Ulmstedt/Synth/docs/Bilder/20150524_132819.jpg

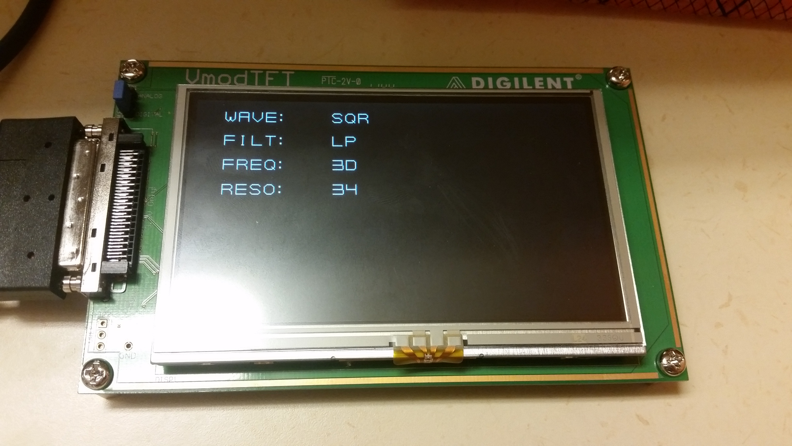
docs/Bilder/20150524_132819.jpg
