Ulmstedt/Synth/docs/Bilder/20150524_132806.jpg

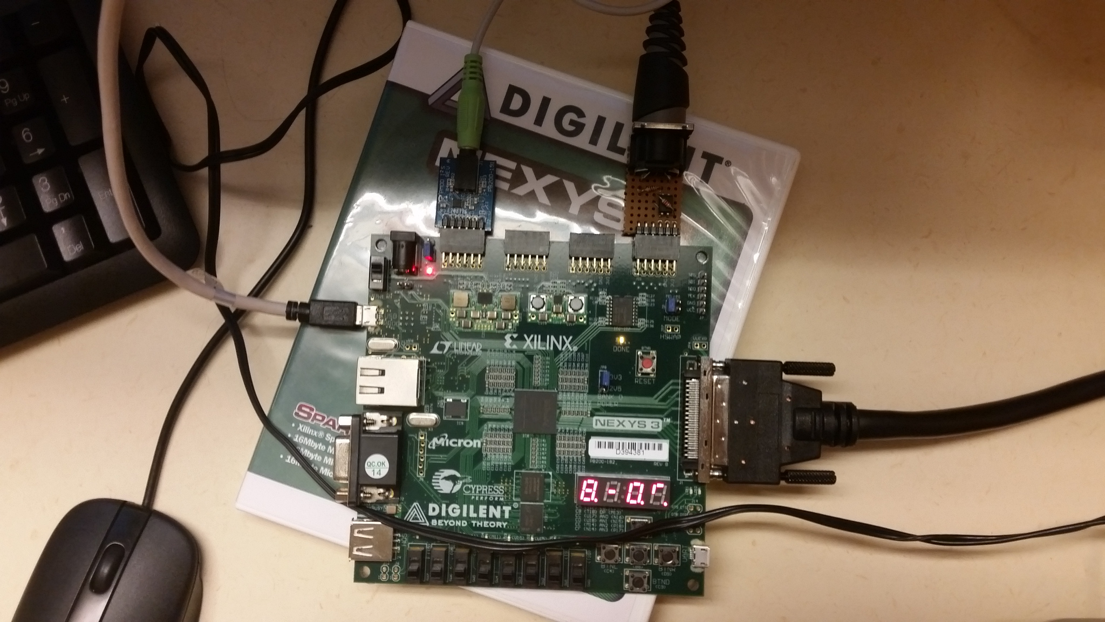
docs/Bilder/20150524_132806.jpg
