Ulmstedt/Synth/docs/psuedo/description.txt

Version 1:
OSCs (only 1, 3 voices)
   => Mixer 
      => Filter (up to 2)
         => Mixer
            => Output
