Ulmstedt/Synth/docs/7-seg display fixed.png

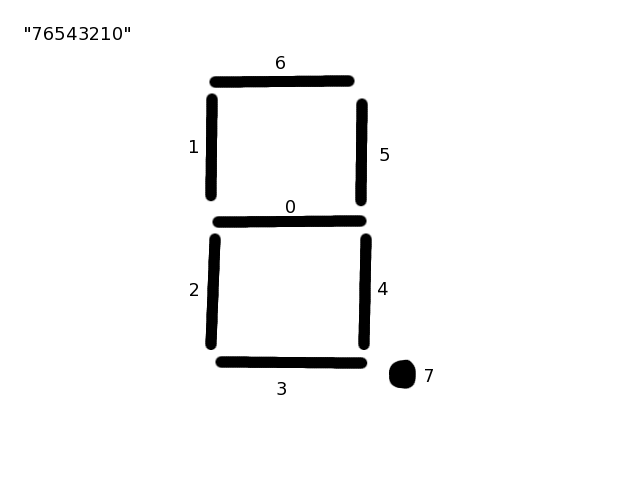
docs/7-seg display fixed.png
