Ulmstedt/Synth/docs/Bilder/20150524_132828.jpg

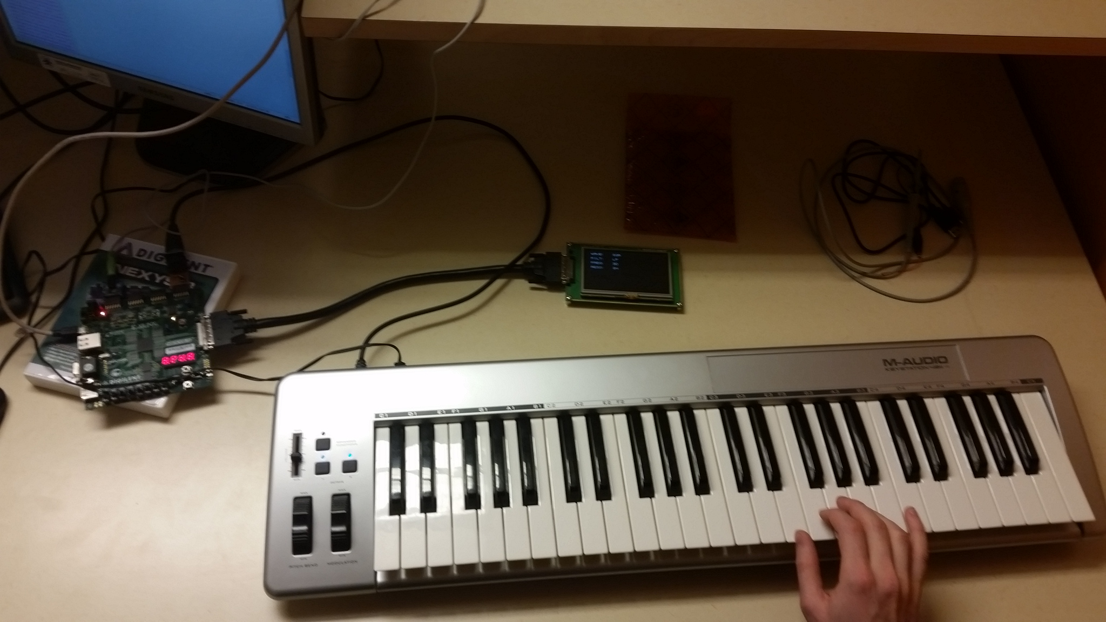
docs/Bilder/20150524_132828.jpg
