Ulmstedt/Synth/docs/Bilder/MinimoogVoyager.jpg

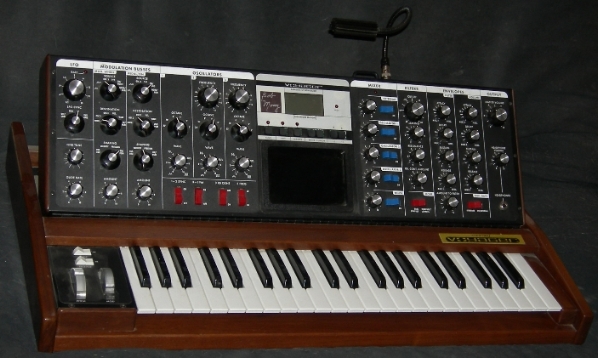
docs/Bilder/MinimoogVoyager.jpg
