Ulmstedt/Synth/docs/JUMPSTALL.png

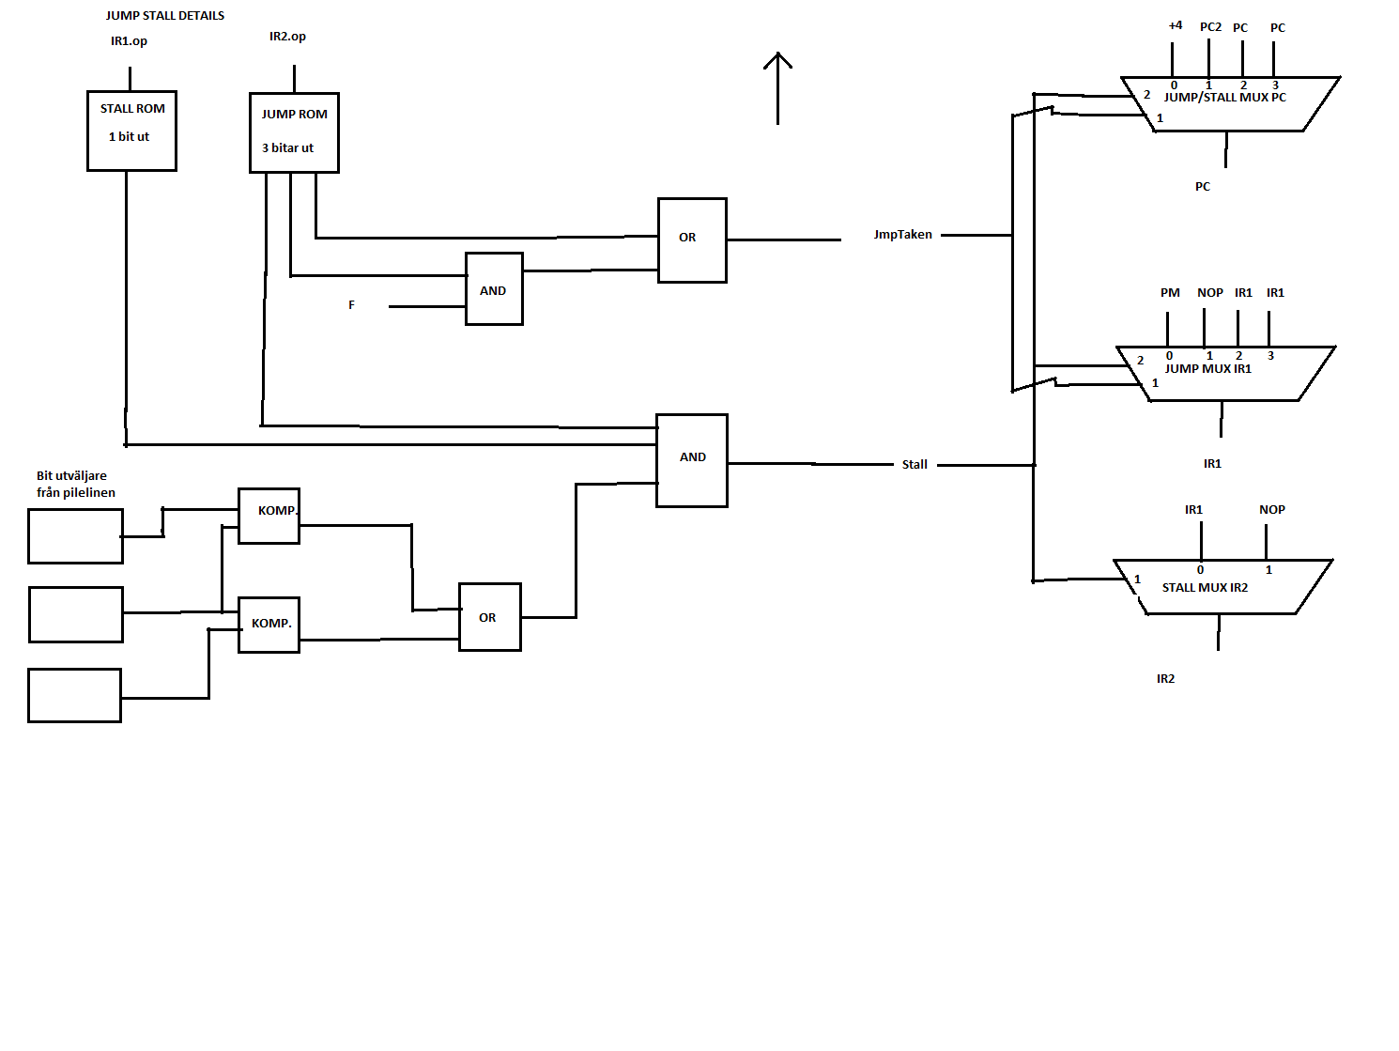
docs/JUMPSTALL.png
