Ulmstedt/Synth/docs/skiss2.png

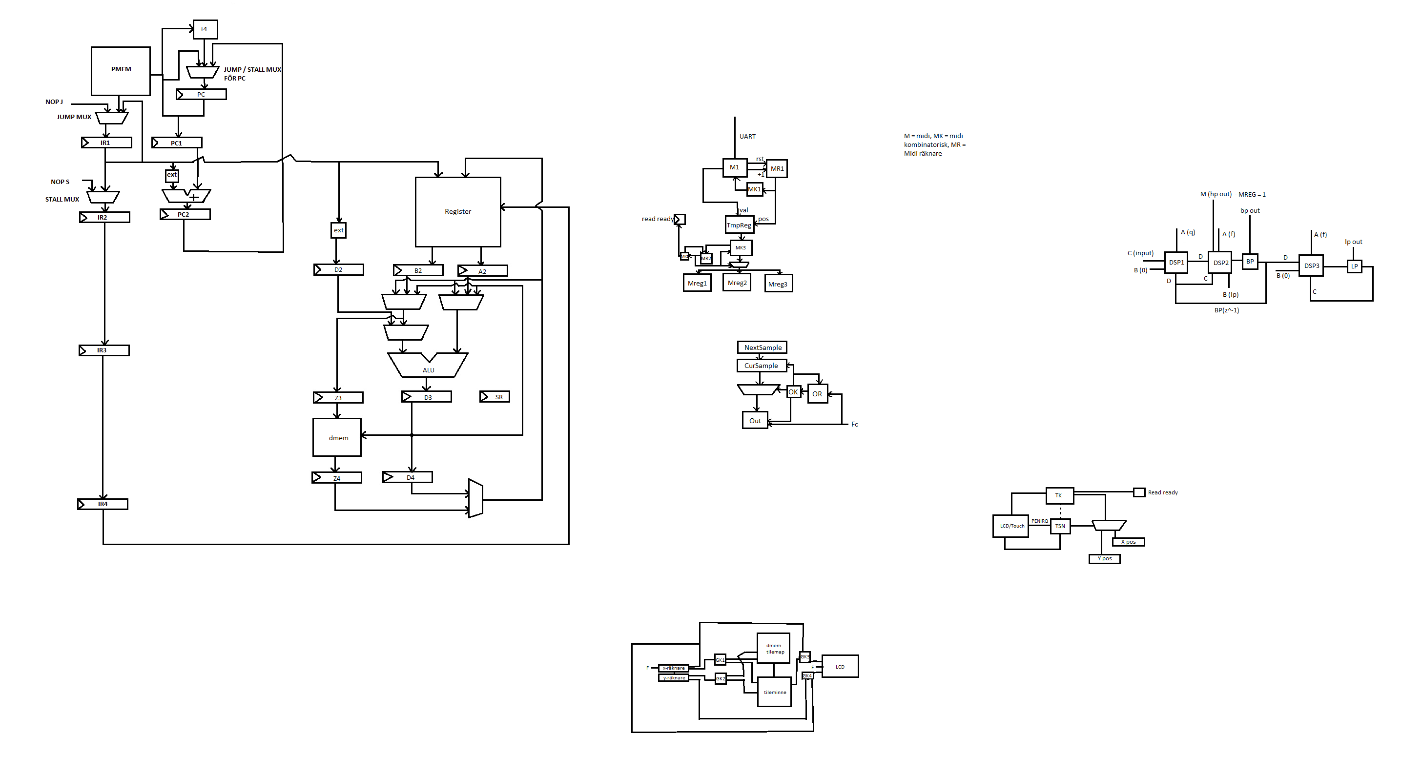
docs/skiss2.png
