Ulmstedt/Synth/compiler/test.txt

&hej
NOP
&hej2
BRA #hej3   ; Kommentar
NOP
NOP
&hej3
