Ulmstedt/Synth/docs/checklista_testing_of_cpu.xls

Skriv typ av test i högra kolumnerna
 | Typ av test:
Instruktion | 1 line | flera lines samma instr.
NOP | ok
TRAP
STORE.c | ok | ok, kan stora på olika adresser osv var tvungen att integrera D3 med ALU ty ALUn är kockad
STORE.r
STORE.wo
STORE.wofr
LOAD.a | ok | verkar ok, var tvungen att integrera Z4 med minnet ty minnet är klockat
LOAD.c
LOAD.wo
LOAD.wro
MOVE
BRANCH(till adress)
BRANCH(offset i register)
BRANCH(offset från där man står)
BCC
BCC(offset i reg)
BCC(offset från där man står)
BNCC
BNCC(offset i reg)
BNCC(offset från där man står)
ALUINST.r
ALUINST.c
