Ulmstedt/Synth/cpu/pmem_content.vhd

library IEEE;
use IEEE.std_logic_1164.all;
use IEEE.numeric_std.all;

use work.records.all;


package pmemContent is
   -- The content of the program memory
   constant pmemc : pmem_t := (
         ("11101100100000000000100000000000"),
         ("11101100110000001111110111101000"),
         ("11101000000000000000000000001010"),
         ("11101000100000000000000000001010"),
         ("00110001110000000000000000001000"),
         ("00110001110001000000000000001000"),
         ("11101000010000000000000000000000"),
         ("00101001010000000000000000000010"),
         ("00000000000000000000000000000000"),
         ("11011001111111110000000000000001"),
         ("00000000000000000000000000000000"),
         ("00110001000000000000000000000001"),
         ("00110011000000000000000000000000"),
         ("00000000000000000000000000000000"),
         ("10100000000000000000000000001000"),
         ("00000000000000000000000000000000"),
         ("11000001111101000000000110100101"),
         ("11000001111101010111111111111111"),
         ("10000011100000000000000000011010"),
         ("00000000000000000000000000000000"),
         ("10000010100000000000000010001011"),
         ("00000000000000000000000000000000"),
         ("10000011000000000000000010110110"),
         ("00000000000000000000000000000000"),
         ("01000000000000000000000000010010"),
         ("00000000000000000000000000000000"),
         ("00100010100000000000000000011101"),
         ("00110001100101000000000000001100"),
         ("00100000000000000000000000011101"),
         ("00110010000000000000000011111111"),
         ("00100000010000000000000000011110"),
         ("00110011000101000000000000001011"),
         ("10000000000000000000000001010001"),
         ("00000000000000000000000000000000"),
         ("00110011000101000000000000001110"),
         ("10000000000000000000000001100100"),
         ("00000000000000000000000000000000"),
         ("00110011000000000000000001010100"),
         ("10000000000000000000000010001000"),
         ("00000000000000000000000000000000"),
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

      others =>
         ("00000" & "000" & "0000" & "0000" & "0000" & "0000" & "0000" & "0000")
      );
      
end pmemContent;
