Ulmstedt/Synth/TouchLCD/InputtoLCD/tilememcontent.vhd

--Tiles are stored here

library IEEE;
use IEEE.std_logic_1164.all;
use IEEE.numeric_std.all;

use work.Constants.all;

   --1 tile = 16x16 pixlar
   --30 tiles i x-led
   --17 tiles i y-led
   --30*17= tiles totalt på skärmen
   --dmem 16 bitar brett
   -- XXXX XXXX XXXX XXXX
   --Behöver 5 bitar för att peka ut rätt tile i tilemem
   -- Varje minnesplats i dmem får hålla reda på 3 tiles
   --1 vit
   --0 svart

package tilememContent is
   type tile_mem_c is array (0 to TILE_DIM - 1) of std_logic_vector(0 to TILE_DIM - 1);
   type tile_mem_t is array (0 to TILE_MEM_HEIGHT - 1) of tile_mem_c;

   constant tileMemoryContent : tile_mem_t := (
         --0
         (("0011111111111100"),
          ("0010000000001100"),
          ("0010000000010100"),
          ("0010000000100100"),
          ("0010000001000100"),
          ("0010000010000100"),
          ("0010000100000100"),
          ("0010001000000100"),
          ("0010010000000100"),
          ("0010100000000100"),
          ("0011000000000100"),
          ("0010000000000100"),
          ("0011111111111100"),
          ("0000000000000000"),
          ("0000000000000000"),
          ("0000000000000000")),
         --1
         (("0000000010000000"),
          ("0000000110000000"),
          ("0000001010000000"),
          ("0000000010000000"),
          ("0000000010000000"),
          ("0000000010000000"),
          ("0000000010000000"),
          ("0000000010000000"),
          ("0000000010000000"),
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
          ("0000000000000000"),
          ("0001100000000000"),
          ("0001100000000000"),
          ("0000000000000000"),
          ("0000000000000000"),
          ("0000000000000000"),
          ("0000000000000000"),
          ("0000000000000000"))
      );
      
end tilememContent;
