Ulmstedt/Synth/cpu/mem_content.vhd

library IEEE;
use IEEE.std_logic_1164.all;
use IEEE.numeric_std.all;

use work.records.all;
use work.Constants.all;


package memContent is
   constant memc : mem_t := (
      -- Wavetables note multipliers (calculated in advance as: freq * wavetable_length / sample rate
      ("0000000010110000"), -- C0
      ("0000000010111010"),
      ("0000000011000101"),
      ("0000000011010001"),
      ("0000000011011101"),
      ("0000000011101010"),
      ("0000000011111000"),
      ("0000000100000111"),
      ("0000000100010111"),
      ("0000000100100111"),
      ("0000000100111001"),
      ("0000000101001011"),
      ("0000000101011111"),
      ("0000000101110100"),
      ("0000000110001010"),
      ("0000000110100010"),
      ("0000000110111010"),
      ("0000000111010101"),
      ("0000000111110000"),
      ("0000001000001110"),
      ("0000001000101101"),
      ("0000001001001111"),
      ("0000001001110010"),
      ("0000001010010111"),
      ("0000001010111110"),
      ("0000001011101000"),
      ("0000001100010100"),
      ("0000001101000011"),
      ("0000001101110101"),
      ("0000001110101010"),
      ("0000001111100001"),
      ("0000010000011100"),
      ("0000010001011011"),
      ("0000010010011101"),
      ("0000010011100100"),
      ("0000010100101110"),
      ("0000010101111100"),
      ("0000010111010000"),
      ("0000011000101000"),
      ("0000011010000111"),
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
      -- 64 step square wave
      ("1000000001000000"), 
      ("1000000001000000"), 
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
      ("1011100000100100"), 
      ("1011000000101000"), 
      ("1010100000101100"), 
      ("1010000000110000"), 
      ("1001100000110100"), 
      ("1001000000111000"), 
      ("1000100000111100"), 
      ("1000000001000000"), 
      ("1000100000111100"), 
      ("1001000000111000"), 
      ("1001100000110100"), 
      ("1010000000110000"), 
      ("1010100000101100"), 
      ("1011000000101000"), 
      ("1011100000100100"), 
      ("1100000000100000"), 
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
      -- Cordic
      --TILE_MAP_OFFSET =>
      --   ("0000" & "0001" & "0000" & "0001" ),
      --TILE_MAP_OFFSET + 4 =>
      --   ("0000" & "0001" & "0000" & "0001" ),
      others =>
         ("0000" & "0000" & "0000" & "0000" )
      );
      
end memContent;
