Ulmstedt/Synth/cpu/tilemap_content.vhd

--Actual tilemap

library IEEE;
use IEEE.std_logic_1164.all;
use IEEE.numeric_std.all;

use work.records.all;
use work.Constants.all;


package tilemapContent is
   constant tilemapc : tilemap_t := (
         ("00011110" & "00011110" ),
         ("00011110" & "00011110" ),
         ("00011110" & "00011110" ),
         ("00011110" & "00011110" ),
         ("00011110" & "00011110" ),
         ("00011110" & "00011110" ),
         ("00011110" & "00011110" ),
         ("00011110" & "00011110" ),
         ("00011110" & "00011110" ),
         ("00011110" & "00011110" ),
         ("00011110" & "00011110" ),
         ("00011110" & "00011110" ),
         ("00011110" & "00011110" ),
         ("00011110" & "00011110" ),
         ("00011110" & "00011110" ),

         ("00011110" & "00011110" ),   -- 768+15=783
         ("00011100" & "00001010" ),   -- WA
         ("00011011" & "00001110" ),   -- VE
         ("00011111" & "00011110" ),   -- :
         ("00011110" & "00011110" ),
         ("00011110" & "00011110" ),
         ("00011110" & "00011110" ),
         ("00011110" & "00011110" ),   -- Value here
         ("00011110" & "00011110" ),
         ("00011110" & "00011110" ),
         ("00011110" & "00011110" ),
         ("00011110" & "00011110" ),
         ("00011110" & "00011110" ),
         ("00011110" & "00011110" ),
         ("00011110" & "00011110" ),

         
         ("00011110" & "00011110" ),
         ("00011110" & "00011110" ),
         ("00011110" & "00011110" ),
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
         ("00011110" & "00011110" ),
         ("00011110" & "00011110" ),
         ("00011110" & "00011110" ),
         ("00011110" & "00011110" ),
         ("00011110" & "00011110" ),

      others =>
         ("00011110" & "00011110" )
      );
      
end tilemapContent;
