Ulmstedt/Synth/midiinput/midi_mux_counter.vhd

library IEEE;
use IEEE.std_logic_1164.all;
use IEEE.numeric_std.all;

use work.midi_constants.all;

-- This section makes sure that the MIDI messages are saved to the correct registers

entity MuxCounter is
   port(
      clk               : in std_logic; -- Clock
      rst               : in std_logic; -- Reset
      validMsgI         : in std_logic; -- 1 when the message in tmpReg is valid
      msgReadyDelayed   : in std_logic; -- 1 when a message is ready in tmpReg
      muxCtr            : out std_logic_vector(1 downto 0); -- MUX counter
      outReady          : out std_logic -- 1 when the message is ready to be transfered from tmpReg to mreg#
   );
end MuxCounter;

architecture Behavioral of MuxCounter is

signal count      : std_logic_vector(1 downto 0) := "00";
signal outReadyS  : std_logic := '0';

begin

   process(clk) is
   begin
      if rising_edge(clk) then
         if rst = '1' then
            count <= "00";
         else
           if validMsgI = '1' and msgReadyDelayed = '1' then
               case count is
                  when "00" =>
                           count <= "01";
                           outReadyS <= '1';
                  when "01" =>
                           count <= "10";
                           outReadyS <= '1';
                  when "10" =>
                           count <= "11";
                           outReadyS <= '1';
                  when others => null;
               end case;
            elsif validMsgI = '0' then
               count <= "00";
            end if;
           
            -- Out ready should only be 1 for 1 clk
            if outReadyS = '1' then
               outReadyS <= '0';
            end if;
            
         end if;
      end if;
   end process;

   muxCtr <= count;
   outReady <= outReadyS;


end Behavioral;
