Ulmstedt/Synth/TouchLCD/backlightpwmsignal.vhd

--transform clk signal to pwm signal to drive backlight of LCD
library IEEE;
use IEEE.std_logic_1164.all;
use IEEE.numeric_std.all;

entity backlightpwmsignal is
   port(
      rst   : in std_logic;
      clk   : in std_logic;
      F     : out std_logic --desired frequency 50 kHz
   );
end backlightpwmsignal;

architecture Behavioral of backlightpwmsignal is
   signal temp   :  std_logic;
   signal counter: integer range 0 to 999 := 0; --(100 000 000 / 50 000)/2

   
--Produces a clock frequency of 50kHz
begin
   process(clk)
   begin
   if(rising_edge(clk)) then
      if(rst = '1') then
         temp <= '0'; --0
         counter <= 0;
      elsif(counter = 999) then
         temp <= not(temp);
         counter <= 0;
      else
         counter <= counter + 1;
      end if;
   end if;
   end process;

   F <= temp;
end Behavioral;
