Ulmstedt/Synth/svf/filter_phase1.vhd

-- Filter Phase 1:
--  - Multipliation with f
--  - Picks out the HP output

library IEEE;
use IEEE.std_logic_1164.all;
use IEEE.numeric_std.all;

use work.FilterConstants.all;

entity Filter_Phase_1 is
   port(
      input    : in std_logic_vector(AUDIO_WIDTH - 1 downto 0);
      output   : out std_logic_vector(AUDIO_WIDTH - 1 downto 0);
      hp_out   : out std_logic_vector(AUDIO_WIDTH - 1 downto 0);
      f        : in std_logic_vector(AUDIO_WIDTH - 1 downto 0)
   );
end Filter_Phase_1;

architecture Behavioral of Filter_Phase_1 is
   signal o    : std_logic_vector(2*AUDIO_WIDTH - 1 downto 0);
begin
   o <= std_logic_vector(signed(input) * signed(f));
   hp_out <= input;
   output <= o(2 * AUDIO_WIDTH - 1 downto AUDIO_WIDTH);
end Behavioral;
