Ulmstedt/Synth/midiinput/midi_constants.vhd

package midi_constants is
   constant UART_CLK_PERIOD  	      : natural := 3200; -- MIDI: 3200
	constant UART_CLK_PERIOD_WIDTH   : natural := 12;
   constant MIDI_WIDTH       	      : natural := 8;
end midi_constants;
