Ulmstedt/Synth/(commit log)

2015-03-26 MIDI UART input v0.1
2015-03-27 Tried to fix ALU
    [alu.vhd]
2015-04-01 alu made it through simulations, although not every single case was accounted for it worked for cases in alutb
2015-04-01 Added old lab docs
    [Labb 1.ods]
2015-04-01 Stall additional logic, and more work on regs and the d reg
    [const.vhd, d_reg.vhd, ir1.vhd, pmem_area.vhd]
2015-04-11 re forwarding muxes + comment on load eventual stalling
    [alu_muxes.vhd]
2015-04-16 Sound output testing
    [Labb 1.ods]
2015-04-17 Fixed unfixed merge conflicts
    [alu.vhd, cpu_area.vhd, d_reg.vhd, main_area.vhd, mem.vhd, pmem_area.vhd, reg_area.vhd]
2015-04-17 load.a store.c should be working
    [checklista_testing_of_cpu.xls]
2015-04-18 A couple of small bug fixes
    [alu.vhd, alu_area.vhd, const.vhd, jmp.vhd, main_area.vhd, pmem_content.vhd, reg_area.vhd, z4d4mux.vhd]
2015-04-19 ALU kombinatorisk nu, d3 återinförd, fixat logik för att dataforwarding skall ignorera de ALU instruktioner som inte ändrar i regs, även testat load.a och store.c igen och de fungerar
    [alu.vhd, alu_area.vhd, leftforwardinglogic.vhd, main_area.vhd, pmem_content.vhd, rightforwardinglogic.vhd]
2015-04-21 Saving test case
2015-04-21 more bugs fixed, I mean features
    [alu.vhd, alu_muxes.vhd, const.vhd, main_area.vhd, pmem_content.vhd, reg_area.vhd]
2015-04-22 Added timer and fix for load.wofr
    [pmem_content.vhd, reg_area.vhd, timer.vhd]
2015-04-23 move funkar + b�rjat med LCDin stuff
2015-04-24 Added untested SVF filter
2015-04-24 Actually added the filter files..
2015-04-27 Roughly located error, however no clue why the error occurs
    [pmem_content.vhd, reg_area.vhd, sout.vhd, sout_clkgen.vhd, synth.vhd]
2015-04-28 Small tweaks to attempt to fix the synthing
    [alu.vhd, alu_area.vhd, jmp.vhd, midi_uart_input.vhd, pcreg.vhd, pmem.vhd, pmem_area.vhd, reg.vhd]
2015-04-30 Fixed error with reading midi
    [cpu_area.vhd, midi_area.vhd, midi_check_msg.vhd, midi_tb.vhd, midi_uart_input.vhd, pmem_area.vhd, synth.vhd]
2015-05-03 Started testing with filter
2015-05-05 Filter works and working on pseudo code
2015-05-06 MIDI input from keyboard is buggy
    [coord_converter.vhd, midi_constants.vhd, midi_tb.vhd, midi_uart_input.vhd, synth.vhd, touch.vhd, touch_interface.vhd]
2015-05-06 fixed lcdarea connectors, goes throug hbitgen now soon ready for actual testing just some more simulating
    [GK1.vhd, GK2.vhd, LCDInputarea.vhd, LCD_tb.vhd, LCDinput_tb.vhd, XCounter.vhd, YCounter.vhd, backlightpwmsignal.vhd]
2015-05-07 Added fixed doc for 7-seg disp
    [synth.vhd]
2015-05-07 LCD screen works, started testing with touch but its buggy
    [const.vhd, cpu_area.vhd, main_area.vhd, mem.vhd, mem_content.vhd, midi_uart_input.vhd, reg_area.vhd]
2015-05-21 implementing filter
2015-05-22 First go at filtering properly with parameters is under way
2015-05-25 Teknisk rapport mm tillagt
    [Labb 1.ods]
